york-fs/tsal-ups/tsal-ups.kicad_pcb

## KiCad design tsal-ups.kicad_pcb (2025-11-03)

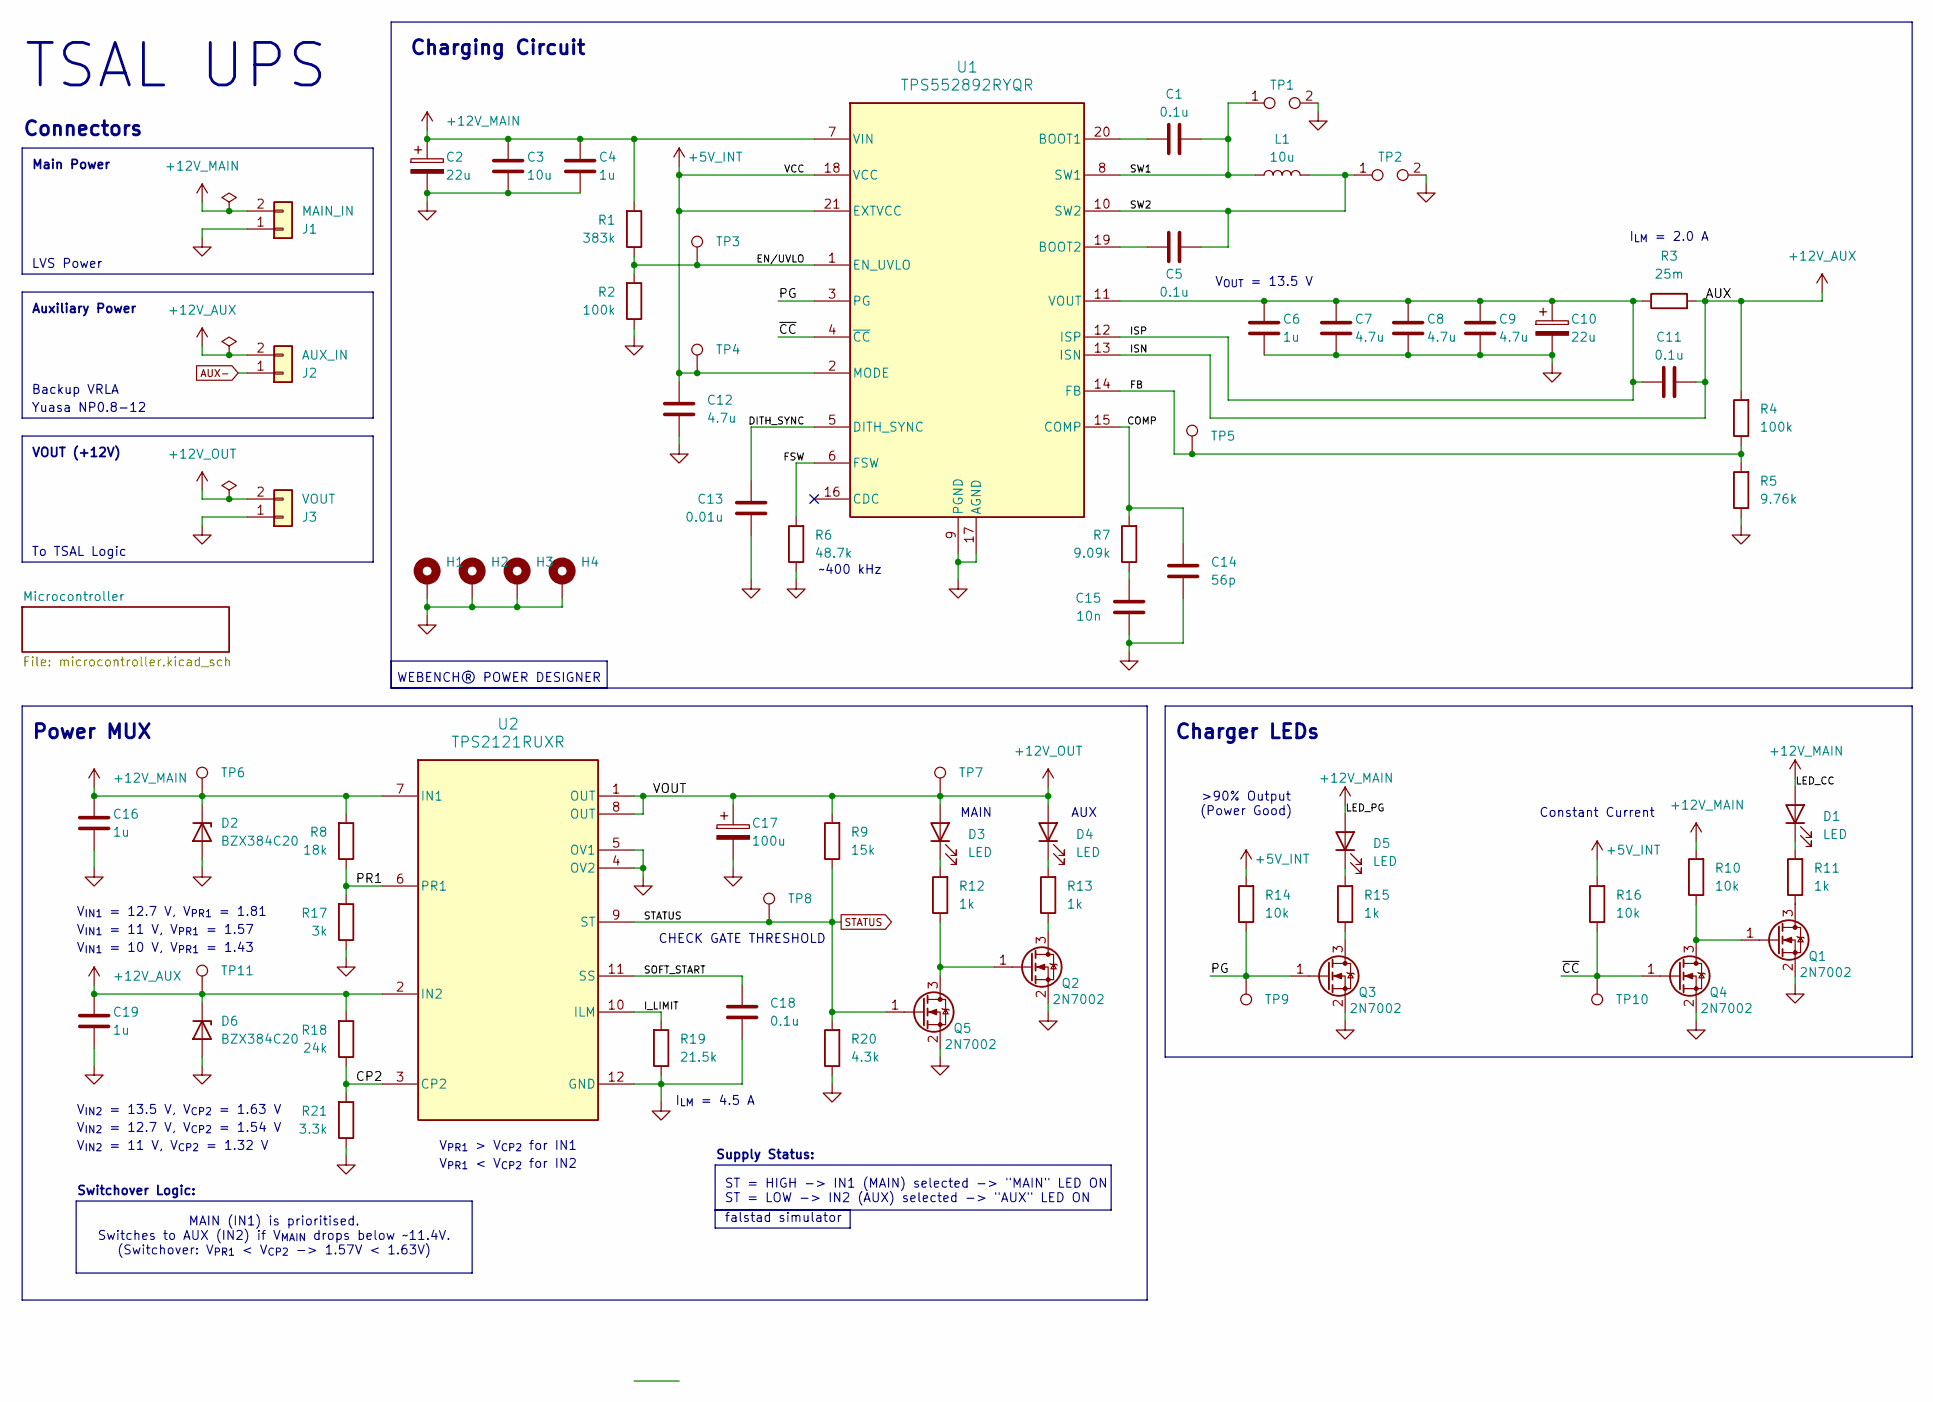
[picture p1: schematic tsal-ups.kicad_sch, TSAL UPS]

Parts:
C1, C5, C11, C18: 0.1u; C_0603_1608Metric
C2, C10: 22u; CP_Elec_6.3x7.7
C3: 10u; C_0805_2012Metric
C4, C6, C16, C19: 1u; C_0603_1608Metric
C7, C8, C9, C12: 4.7u; C_0805_2012Metric
C13: 0.01u; C_0603_1608Metric
C14: 56p; C_0603_1608Metric
C15: 10n; C_0603_1608Metric
C17: 100u; CP_Elec_6.3x7.7
D1, D3, D4, D5: LED; LED_0603_1608Metric
D2, D6: BZX384C20; D_SOD-323
H1, H2, H3, H4: MountingHole_Pad; MountingHole_3.2mm_M3_Pad_Via
J1: MAIN_IN; MolexMicrofitPlus1x2
J2: AUX_IN; MolexMicrofitPlus1x2
J3: VOUT; MolexMicrofitPlus1x2
L1: 10u; L_APV_APH0850
Q1, Q2, Q3, Q4, Q5: 2N7002; SOT-23
R1: 383k; R_0603_1608Metric
R2, R4: 100k; R_0603_1608Metric
R3: 25m; R_1206_3216Metric
R5: 9.76k; R_0603_1608Metric
R6: 48.7k; R_0603_1608Metric
R7: 9.09k; R_0603_1608Metric
R8: 18k; R_0603_1608Metric
R9: 15k; R_0603_1608Metric
R10, R14, R16: 10k; R_0603_1608Metric
R11, R12, R13, R15: 1k; R_0603_1608Metric
R17: 3k; R_0603_1608Metric
R18: 24k; R_0603_1608Metric
R19: 21.5k; R_0603_1608Metric
R20: 4.3k; R_0603_1608Metric
R21: 3.3k; R_0603_1608Metric
TP1, TP2: TestPoint_2Pole; TestPoint_2Pads_Pitch2.54mm_Drill1.0mm
TP3, TP4, TP5, TP6, TP7, TP8, TP9, TP10, TP11: TestPoint; TestPoint_Pad_D1.5mm
U1: TPS552892RYQR
U2: TPS2121RUXR; RUX0012A

Connections:
+5V_INT: C12.2, R14.2, R16.2, TP4.1, U1.2 (MODE), U1.18 (VCC), U1.21 (EXTVCC)
+12V_AUX: C11.1, C19.2, D6.1 (K), J2.2, R3.2, R4.2, R18.2, TP11.1, U1.13 (ISN), U2.2 (IN2)
+12V_MAIN: C2.1, C3.2, C4.2, C16.2, D1.2 (A), D2.1 (K), D5.2 (A), J1.2, R1.2, R8.2, R10.2, TP6.1, U1.7 (VIN), U2.7 (IN1)
+12V_OUT: C17.1, D3.2 (A), D4.2 (A), J3.2, R9.2, TP7.1, U2.1 (OUT), U2.8 (OUT); also elsewhere on the board
/COMP: C14.2, R7.2, U1.15 (COMP)
/CP2: R18.1, R21.2, U2.3 (CP2)
/DITH_SYNC: C13.2, U1.5 (DITH_SYNC)
/EN/UVLO: R1.1, R2.2, TP3.1, U1.1 (EN_UVLO)
/FB: R4.1, R5.2, TP5.1, U1.14 (FB)
/FSW: R6.2, U1.6 (FSW)
/ISP: C6.2, C7.2, C8.2, C9.2, C10.1, C11.2, R3.1, U1.11 (VOUT), U1.12 (ISP)
/I_LIMIT: R19.2, U2.10 (ILM)
/PG: Q3.1 (G), R14.1, TP9.1, U1.3 (PG)
/PR1: R8.1, R17.2, U2.6 (PR1)
/SOFT_START: C18.2, U2.11 (SS)
/SW1: C1.2, L1.1, TP1.1, U1.8 (SW1)
/SW2: C5.2, L1.2, TP2.1, U1.10 (SW2)
/~CC: Q4.1 (G), R16.1, TP10.1, U1.4 (~CC)
AUX-: J2.1; also elsewhere on the board
GND: C2.2, C3.1, C4.1, C6.1, C7.1, C8.1, C9.1, C10.2, C12.1, C13.1, C14.1, C15.1, C16.1, C17.2, C18.1, C19.1, D2.2 (A), D6.2 (A), H1.1, H2.1, H3.1, H4.1, J1.1, J3.1, Q1.2 (S), Q2.2 (S), Q3.2 (S), Q4.2 (S), Q5.2 (S), R2.1, R5.1, R6.1, R17.1, R19.1, R20.1, R21.1, TP1.2, TP2.2, U1.9 (PGND), U1.17 (AGND), U2.4 (OV2), U2.5 (OV1), U2.12 (GND); also elsewhere on the board
unnamed: C15.2, R7.1
unnamed: D1.1 (K), R11.2
unnamed: D3.1 (K), R12.2
unnamed: D4.1 (K), R13.2
unnamed: D5.1 (K), R15.2
unnamed: Q1.3 (D), R11.1
unnamed: Q1.1 (G), Q4.3 (D), R10.1
unnamed: Q2.3 (D), R13.1
unnamed: Q2.1 (G), Q5.3 (D), R12.1
unnamed: Q3.3 (D), R15.1
unnamed: C1.1, U1.20 (BOOT1)
unnamed: C5.1, U1.19 (BOOT2)
STATUS: Q5.1 (G), R9.1, R20.2, TP8.1, U2.9 (ST); also elsewhere on the board

Notes on the sheet:
falstad simulator
VOUT (+12V)
ST = HIGH -> IN1 (MAIN) selected -> "MAIN" LED ON ST = LOW -> IN2 (AUX) selected -> "AUX" LED ON
MAIN (IN1) is prioritised. Switches to AUX (IN2) if V_{MAIN} drops below ~11.4V. (Switchover: V_{PR1} < V_{CP2} -> 1.57V < 1.63V)
Charging Circuit
V_{IN1} = 11 V, V_{PR1} = 1.57
Supply Status:
WEBENCH® POWER DESIGNER
~400 kHz
V_{OUT} = 13.5 V
LVS Power
V_{IN2} = 11 V, V_{CP2} = 1.32 V
V_{IN1} = 10 V, V_{PR1} = 1.43
Charger LEDs
V_{IN2} = 12.7 V, V_{CP2} = 1.54 V
TSAL UPS
I_{LM} = 2.0 A
To TSAL Logic
V_{IN1} = 12.7 V, V_{PR1} = 1.81
MAIN
V_{PR1} < V_{CP2} for IN2
I_{LM} = 4.5 A
Backup VRLA
V_{PR1} > V_{CP2} for IN1
Constant Current
AUX
Power MUX
Auxiliary Power
Connectors
V_{IN2} = 13.5 V, V_{CP2} = 1.63 V
CHECK GATE THRESHOLD
>90% Output (Power Good)
Main Power
Yuasa NP0.8-12
Switchover Logic:

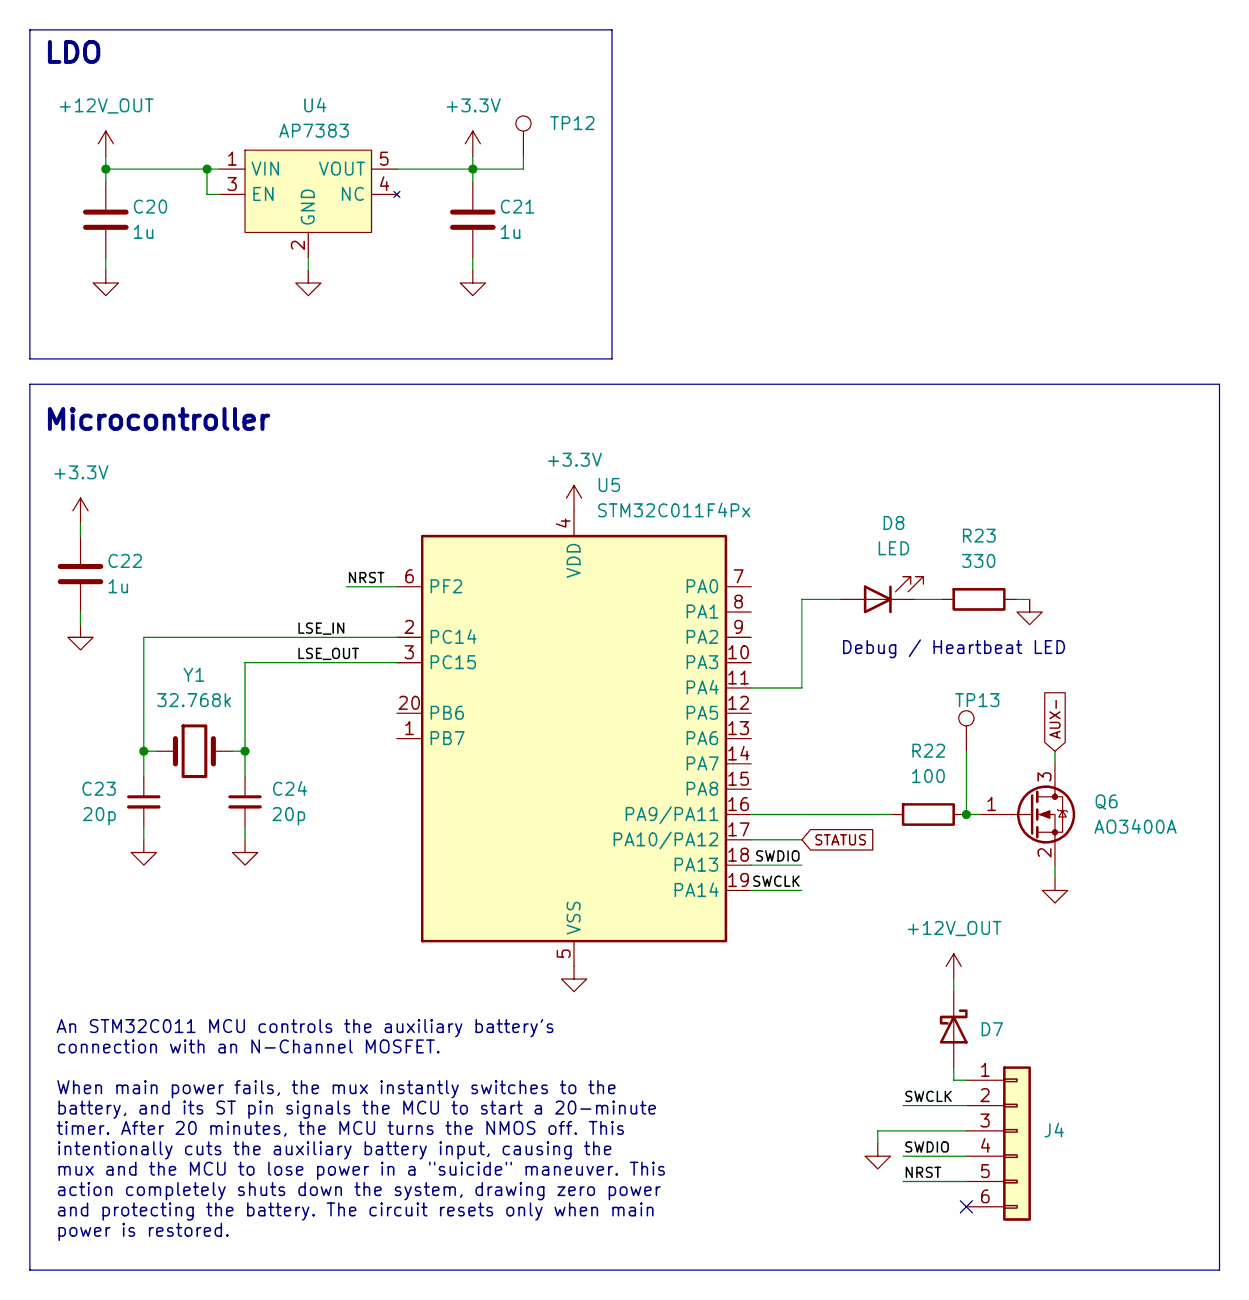
[picture p2: schematic microcontroller.kicad_sch, TSAL UPS]

Parts:
C20, C21, C22: 1u; C_0603_1608Metric
C23, C24: 20p; C_0603_1608Metric
D7: D_Schottky; D_SOD-323; Mfr # NSR0530H
D8: LED; LED_0603_1608Metric
J4: Conn_01x06; IDC-Connector-2x3
Q6: AO3400A; SOT-23
R22: 100; R_0603_1608Metric
R23: 330; R_0603_1608Metric
TP12, TP13: TestPoint; TestPoint_Pad_D1.5mm
U4: AP7383; TSOT-23-5
U5: STM32C011F4Px; TSSOP-20_4.4x6.5mm_P0.65mm
Y1: 32.768k; Crystal_SMD_G8-2Pin_3.2x1.5mm

Connections:
+3.3V: C21.2, C22.2, TP12.1, U4.5 (VOUT), U5.4 (VDD)
+12V_OUT: C20.2, D7.1 (K), U4.1 (VIN), U4.3 (EN); also elsewhere on the board
/Microcontroller/LSE_IN: C23.1, U5.2 (PC14), Y1.1
/Microcontroller/LSE_OUT: C24.1, U5.3 (PC15), Y1.2
/Microcontroller/NRST: J4.5, U5.6 (PF2)
/Microcontroller/SWCLK: J4.2, U5.19 (PA14)
/Microcontroller/SWDIO: J4.4, U5.18 (PA13)
AUX-: Q6.3 (D); also elsewhere on the board
GND: C20.1, C21.1, C22.1, C23.2, C24.2, J4.3, Q6.2 (S), R23.1, U4.2 (GND), U5.5 (VSS); also elsewhere on the board
unnamed: D7.2 (A), J4.1
unnamed: D8.2 (A), U5.11 (PA4)
unnamed: D8.1 (K), R23.2
unnamed: Q6.1 (G), R22.1, TP13.1
unnamed: R22.2, U5.16 (PA9/PA11)
STATUS: U5.17 (PA10/PA12); also elsewhere on the board

Notes on the sheet:
Debug / Heartbeat LED
LDO
An STM32C011 MCU controls the auxiliary battery's connection with an N-Channel MOSFET. When main power fails, the mux instantly switches to the battery, and its ST pin signals the MCU to start a 20-minute timer. After 20 minutes, the MCU turns the NMOS off. This intentionally cuts the auxiliary bat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
Microcontroller

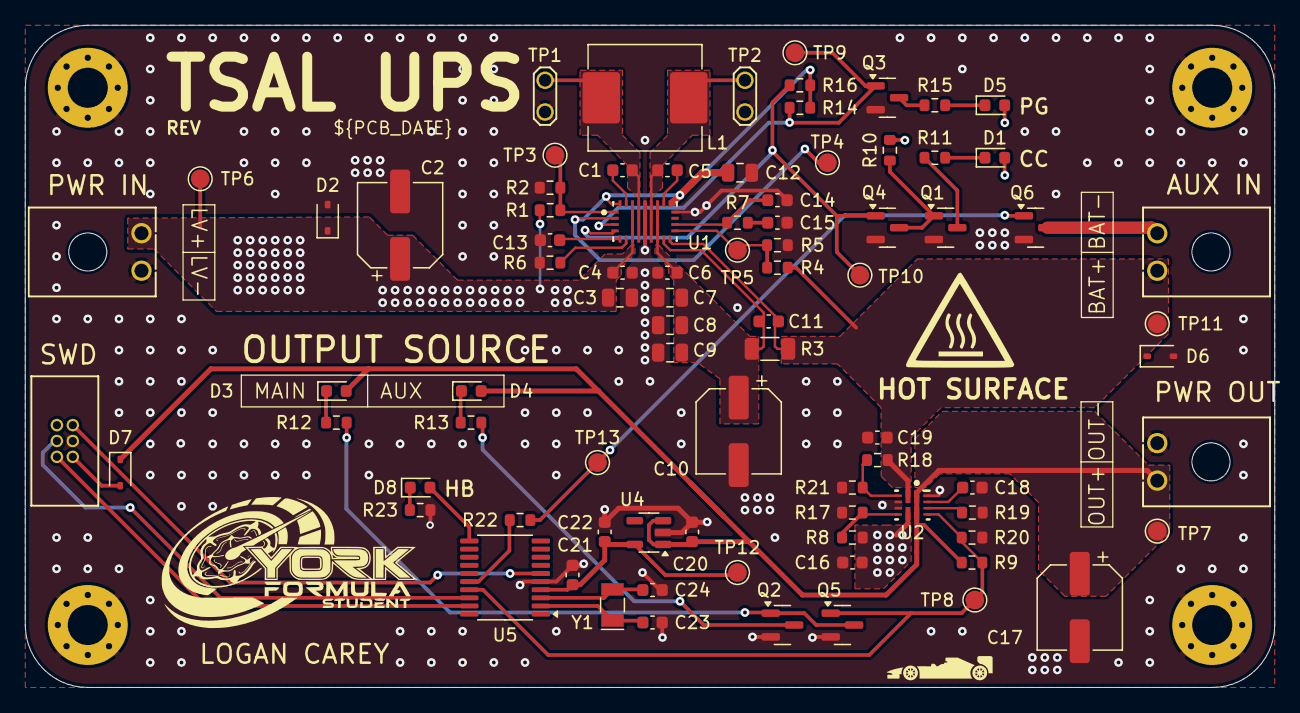
[picture p3: board tsal-ups.kicad_pcb from above]

Board: 4 copper layers, 100.0 x 53.0 mm, 88 parts (0 on the bottom side), 44 nets.
