york-fs/tsal-ups/(commit log)

2025-10-30 kicad-library: Update to latest version
2025-11-03 Revision A
    [microcontroller.kicad_sch, tsal-ups.kicad_pcb, tsal-ups.kicad_sch]
